Team2168/FrankenFrisbeeBot/wiring/Frankenstein Frisbee Robot Wiring.pptx

FRANKENSTEIN FRISBEE BOT WIRING

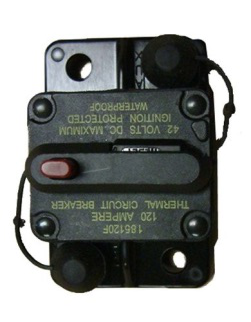
[picture p4: figure]
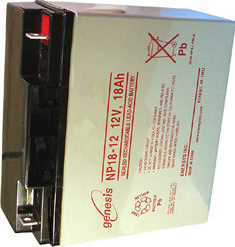
[picture p5: figure]

DRIVETRAIN
RIGHT 2

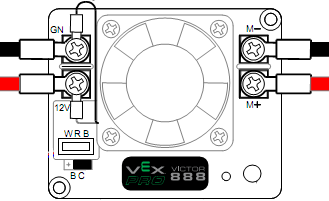
[picture p6: figure]

DRIVETRAIN
LEFT 2

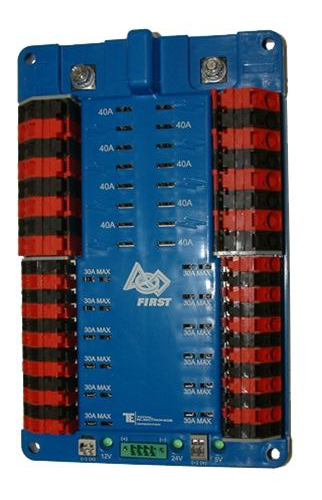
[picture p7: figure]

DRIVETRAIN
LEFT 1

DRIVETRAIN
RIGHT 1

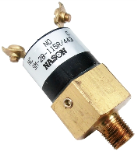
[picture p8: figure]

SHOOTER2

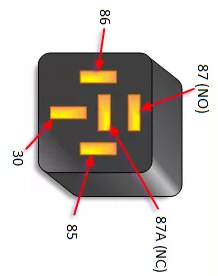
[picture p9: figure]
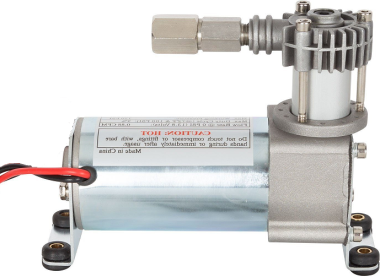
[picture p10: figure]

PWMs to here
& controllers

SHOOTER1

Shooter Controllers MUST be set to COAST

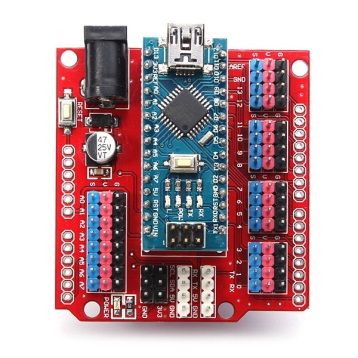
[picture p11: figure]
Image result for arduino nano expansion board

## Slide 2

High pressure storage (120psi)

FRANKENSTEIN FRISBEE BOT PLUMBING

High Low
Pressure Pressure →

Pressure regulator
With pressure gauge

RAISE/LOWER
SHOOTER

FIRE
FRISBEE

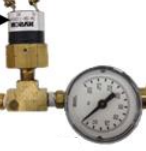
[picture p12: figure]

Note the way this is plumbed, solenoid will extend by default. This is the fail safe state. As retracting this actuator FIRES a Frisbee.

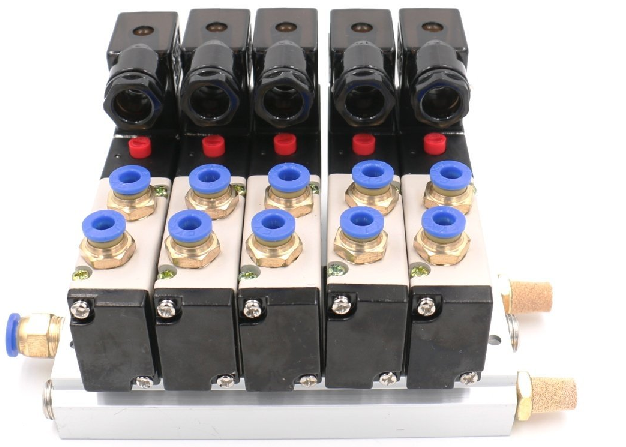
[picture p13: figure]

B

A

S

R

P

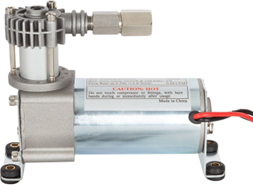
[picture p14: figure]

## Slide 3

SOLENOID VALVE & MANIFOLD INFORMATION

Solenoid State | Port A | Port B
De-energized (OFF) | Pressurized | Vented
Energized (ON) | Vented | Pressurized

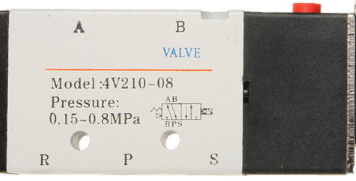
[picture p15: figure]

B

A

S

P

R

Valve Outputs
To Actuators

Pressure inlet
into manifold

Vented Air
Outputs
