Team2168/FrankenFrisbeeBot/(commit log)

2017-11-18 Add wiring / plumbing document
2017-11-18 Update README.md
    Add BOM and images of wiring/plumbing
2017-11-25 First cut at arduino code to sit between receiver and motor controllers.
    Preliminary tests with the TX, RX, and electronic switches appear to be working.
2017-11-26 Move the pins up one to avoid having the enable signal on pin 13. This pin has an LED on it on some boards which appears to affect the state of the enable signal on power up in some cases.
    [arduino_nano.ino]
2017-11-26 Update README.md
    Added some information on the wiring changes made within the FS-I6 transmitter.
2017-11-28 Make sure our default value for servos (during setup) is our safe zero value.
    Also, don't initialize the serial (rx/tx) channels unless we've got debug enabled.
2017-11-29 Change left DT PWM output pin to channel 13 as it appears channel 3 may have been KIA.
